luisluis8414/sim2real_ball_balancer/models/README.md

# Ball balancer v2 CAD assets

## Structure

- `fusion/ball_balancer.f3d`: complete Fusion design
- `fusion/urdf_rdy_ball_balancer.f3d`: Fusion design prepared for URDF export
- `stl/`: ready-to-print parts
- `urdf/`: URDF models, meshes and launch files
- `urdf/isaac/`: corrected Isaac Sim import package
- `usd/scene.usda`: ready-to-open Isaac Sim scene
- `usd/ball_balancer/`: USD model and payloads
- `servo/`: generated, reviewable servo-identification output

## Printed parts

| STL file | Quantity |
| --- | ---: |
| `base.stl` | 1 |
| `lower_link.stl` | 3 |
| `upper_link.stl` | 3 |
| `platform.stl` | 1 |
| `guardrail.stl` | 1 |
| `ball_calibration.stl` | 1 |
| `camera_mast_and_foot.stl` | 1 |
| `camera_overhead_arm.stl` | 1 |

My prints: PLA, 0.4 mm nozzle.
