luisluis8414/sim2real_ball_balancer/models/stl/camera_mast_and_foot.stl

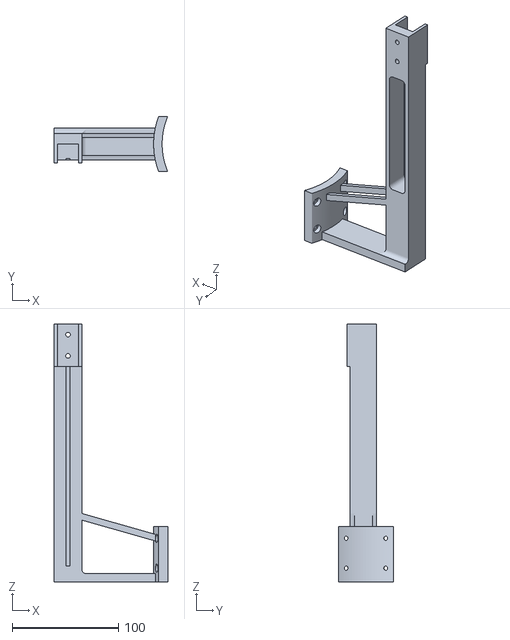
[picture p7: CAD file, 2026-09-09]
models/stl/camera_mast_and_foot.stl
106.8 x 52.0 x 242.6
