luisluis8414/sim2real_ball_balancer/models/urdf/isaac/mm_stl/upper_link_3_1.stl

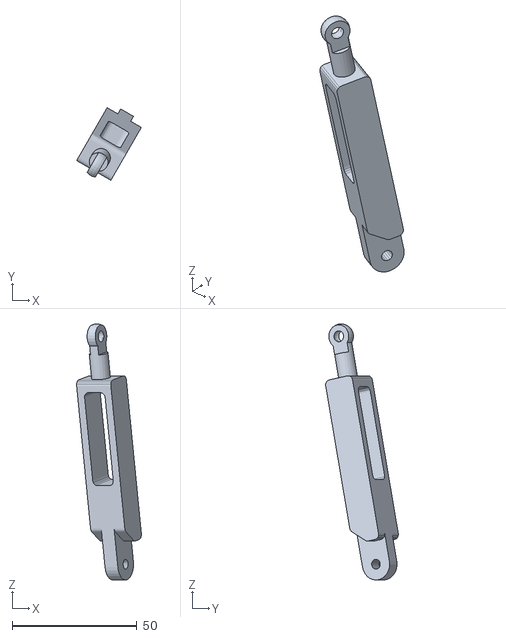
[picture p8: CAD file, 2026-09-09]
models/urdf/isaac/mm_stl/upper_link_3_1.stl
26.0 x 29.2 x 102.8
