luisluis8414/sim2real_ball_balancer/models/urdf/mm_stl/lower_link_1_1.stl

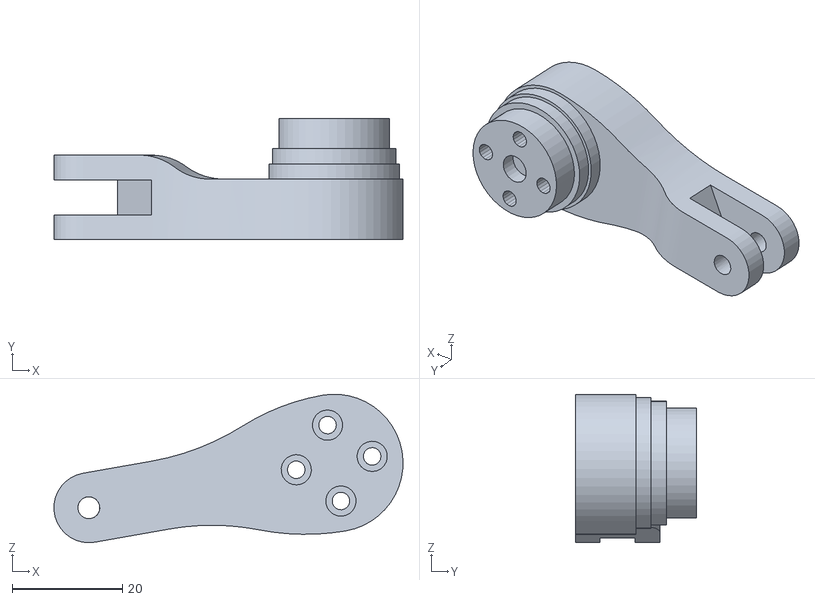
[picture p9: CAD file, 2026-09-09]
models/urdf/mm_stl/lower_link_1_1.stl
63.4 x 22.0 x 26.9
