luisluis8414/sim2real_ball_balancer/models/stl/platform.stl

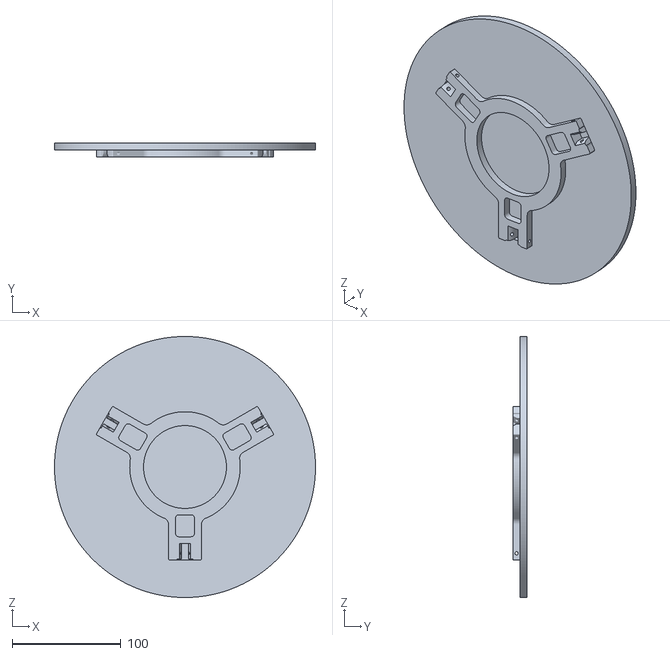
[picture p10: CAD file, 2026-09-09]
models/stl/platform.stl
240.0 x 12.7 x 240.0
