luisluis8414/sim2real_ball_balancer/models/urdf/isaac/mm_stl/upper_link_1_1.stl

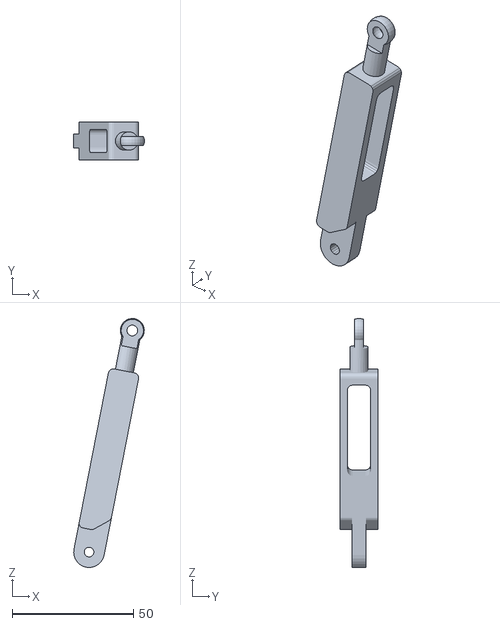
[picture p11: CAD file, 2026-09-09]
models/urdf/isaac/mm_stl/upper_link_1_1.stl
29.1 x 15.9 x 102.8
