luisluis8414/sim2real_ball_balancer/models/urdf/mm_stl/lower_link_2_1.stl

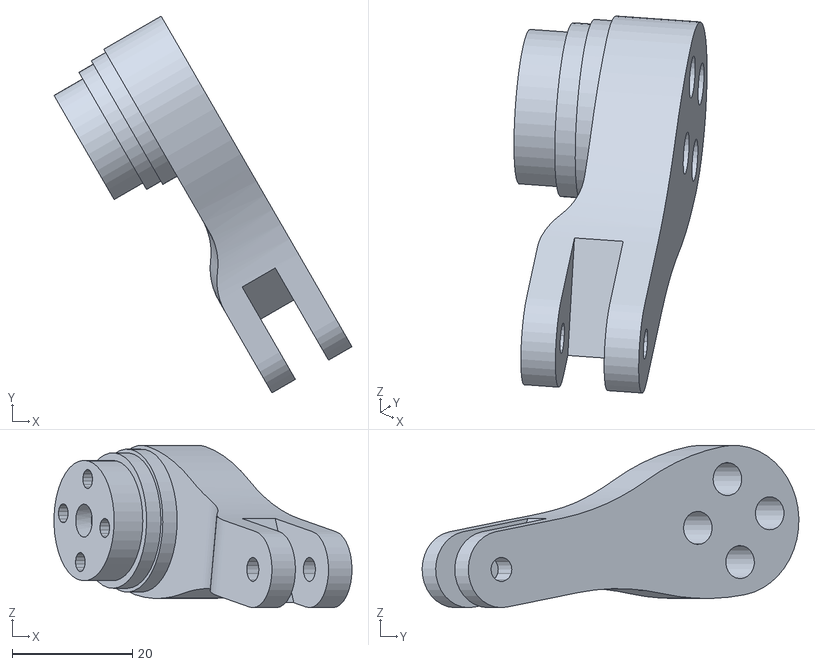
[picture p12: CAD file, 2026-09-09]
models/urdf/mm_stl/lower_link_2_1.stl
49.5 x 62.6 x 27.0
