luisluis8414/sim2real_ball_balancer/models/stl/camera_overhead_arm.stl

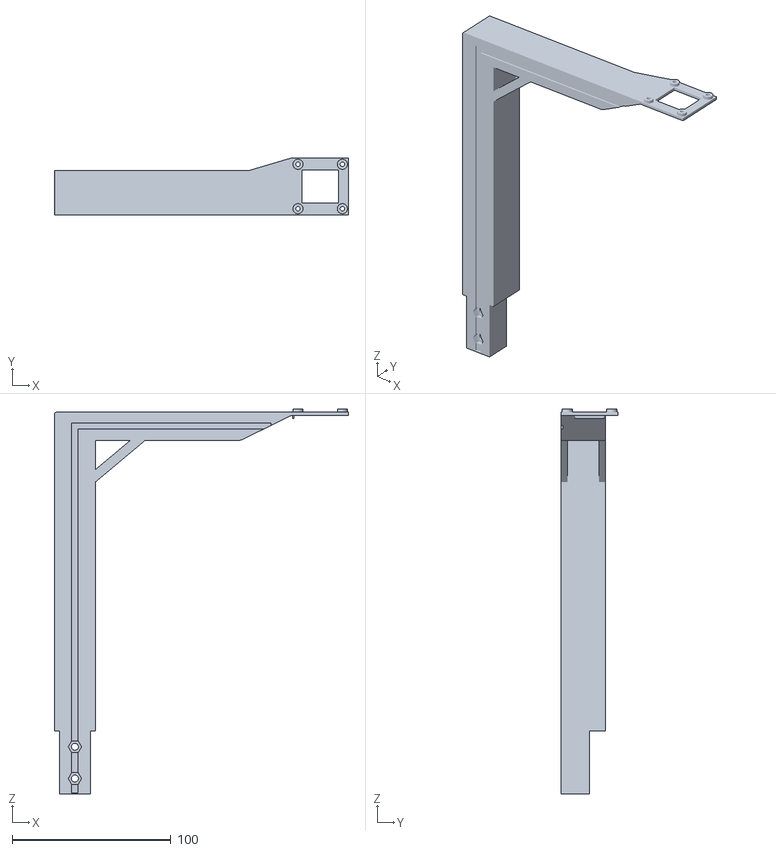
[picture p13: CAD file, 2026-09-09]
models/stl/camera_overhead_arm.stl
185.5 x 36.0 x 242.6
