luisluis8414/sim2real_ball_balancer/models/stl/base.stl

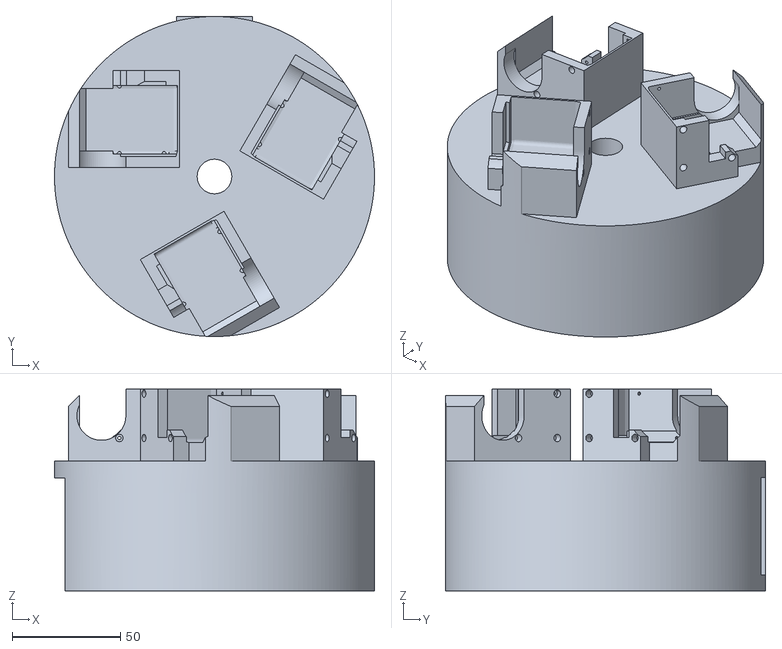
[picture p14: CAD file, 2026-09-09]
models/stl/base.stl
148.0 x 148.0 x 93.4
