luisluis8414/sim2real_ball_balancer/models/urdf/mm_stl/lower_link_3_1.stl

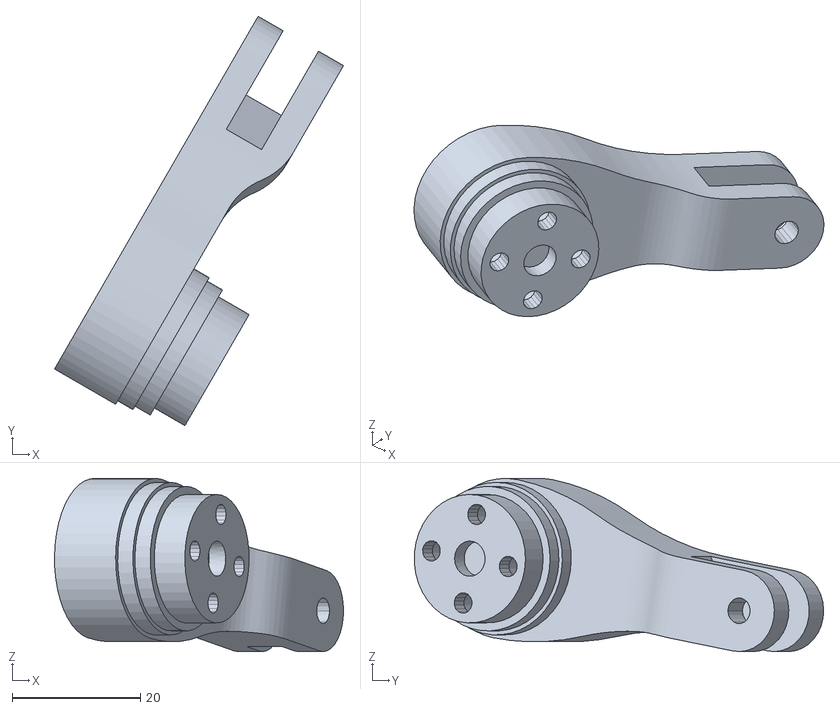
[picture p15: CAD file, 2026-09-09]
models/urdf/mm_stl/lower_link_3_1.stl
45.0 x 63.7 x 27.0
