luisluis8414/sim2real_ball_balancer/models/stl/guardrail.stl

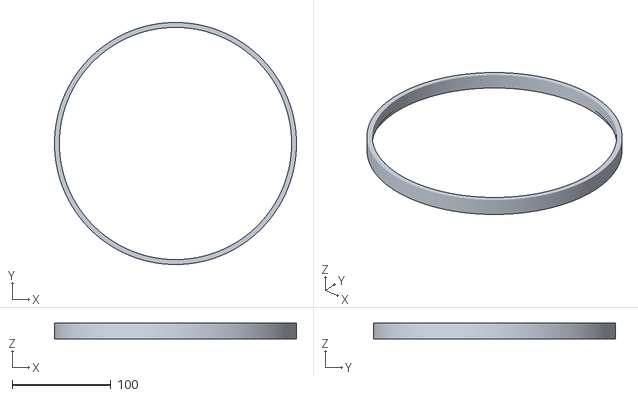
[picture p16: CAD file, 2026-09-09]
models/stl/guardrail.stl
245.0 x 245.0 x 16.0
