luisluis8414/sim2real_ball_balancer/models/stl/lower_link.stl

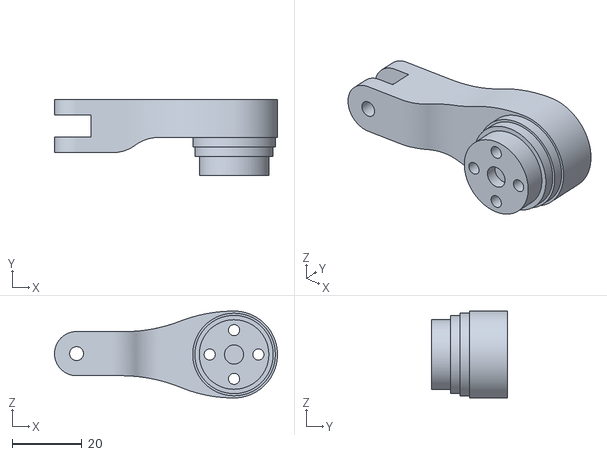
[picture p17: CAD file, 2026-09-09]
models/stl/lower_link.stl
64.1 x 22.0 x 25.0
