luisluis8414/sim2real_ball_balancer/models/stl/upper_link.stl

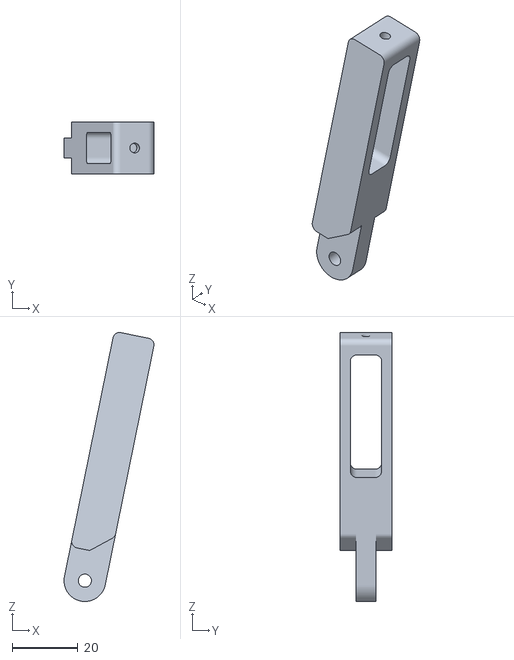
[picture p18: CAD file, 2026-09-09]
models/stl/upper_link.stl
27.4 x 15.9 x 81.9
