luisluis8414/sim2real_ball_balancer/models/urdf/mm_stl/base_link.stl

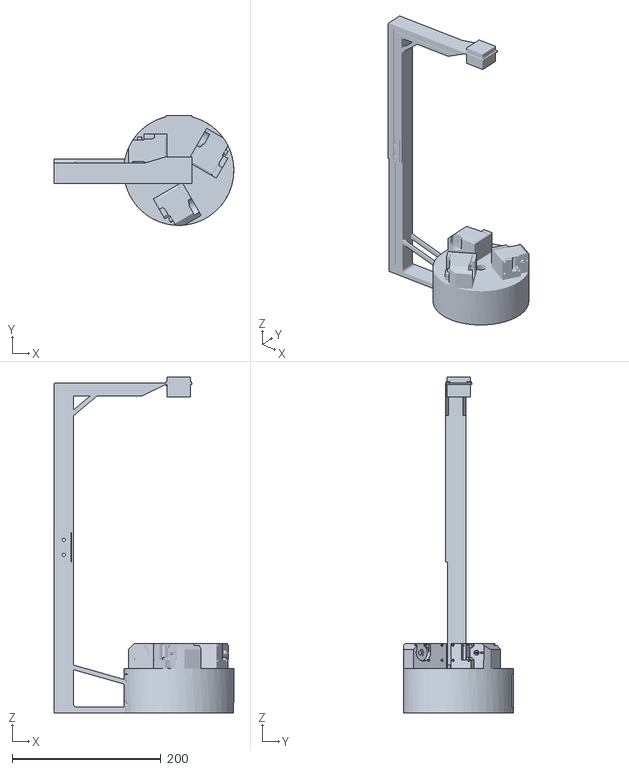
[picture p19: CAD file, 2026-09-09]
models/urdf/mm_stl/base_link.stl
241.5 x 148.5 x 451.5
