luisluis8414/sim2real_ball_balancer/models/stl/ball_calibration.stl

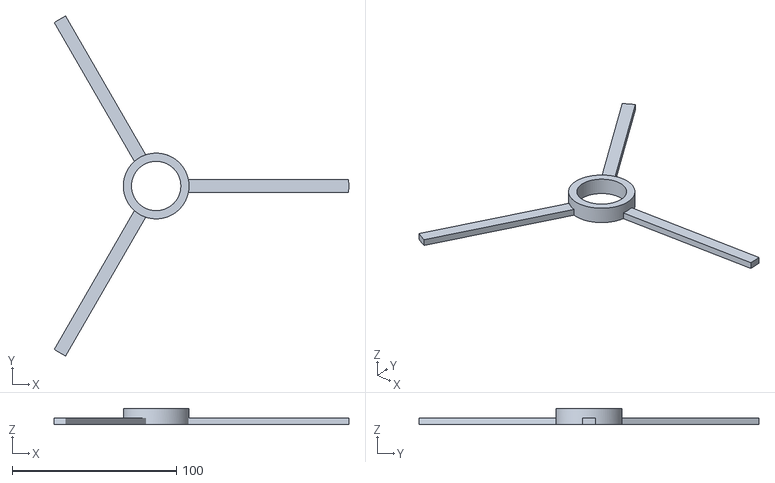
[picture p20: CAD file, 2026-09-09]
models/stl/ball_calibration.stl
179.2 x 206.9 x 10.0
