luisluis8414/sim2real_ball_balancer/(list of files, cad)

Other CAD files:
models/urdf/isaac/mm_stl/platform_link_1.stl
models/urdf/mm_stl/platform_link_1.stl
models/urdf/isaac/mm_stl/upper_link_2_1.stl
models/urdf/mm_stl/upper_link_2_1.stl
models/fusion/ball_balancer.f3d
models/fusion/urdf_rdy_ball_balancer.f3d
