luisluis8414/sim2real_ball_balancer/(commit log)

2025-09-28 move: ball balancer drivers project into main repo
2025-09-28 add: fusion 360 files
    [ball_balancer.f3d, ball_balancer_urdf_rdy.f3d]
2026-09-09 Start v2 with updated Fusion model and printable STEP assets
    [ball_balancer.f3d, ball_balancer.urdf, ball_balancer_urdf_rdy.f3d, ball_calibration.stl, base.stl, base_link.stl, camera_mast_and_foot.stl, camera_overhead_arm.stl]
2026-09-10 add: usda files
    [ball_balancer.f3d, urdf_rdy_ball_balancer.f3d]
2026-09-10 add: servo hardware and platform profiles
2026-09-11 update: PID
